laviniaangan/Audio-Preamplifier/Proiect_1_Angan_Lavinia.pdf

Universitatea Politehnica București Facultatea de Electronică, Telecomunicații și Tehnologia Informației

## PROIECT 1

## PREAMPLIFICATOR AUDIO DE INTRARE CAPITOLUL 5

Profesor coordonator: | Student: Angan Lavinia-Marilena
Dr. Ing. BABARADA Florin | Grupa: 433A

2023-2024

PREAMPLIFICATOR AUDIO DE INTRARE

Un amplificator audio de intrare este un circuit compus din o reţea de adaptare la intrare cu principalele surse de semnale audio (microfon, pick-up cu doză magnetică, pick-up cu doză ceramică, radio, magnetofon sau alte ieşiri de semnal ale aparatelor audio electronice) şi două etaje de amplificare în clasa A, respectiv etajul de intrare şi etajul de ieşire care realizează amplificarea în tensiune a semnalului. Circuitul următor are ca sursă de semnal audio un pick-up cu doză magnetică.

Amplificarea globală a amplificatorului audio de intrare este stabilită de reacţie negativă serie la intrare-paralel la ieşire iar alimentarea celor două etaje de amplificare este realizată de sursa de alimentare.
Schema bloc este prezentată în figura de mai jos:

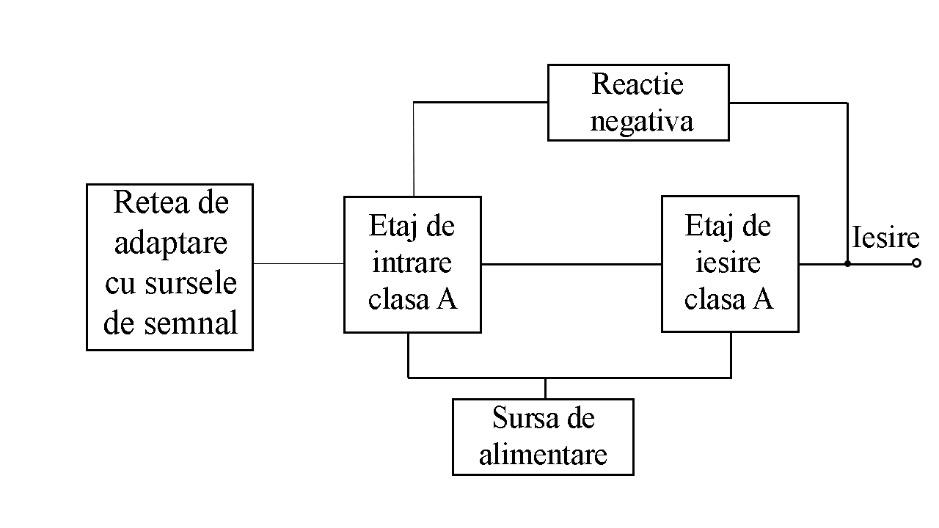
[picture p1: figure]

Figura 1. Schema bloc a amplificatorului audio de intrare

Principalii parametri ai amplificatorului audio de intrare sunt:
- Sensibilitatea minimă la intrare Vin (mV)
- Rezistenţa de intrare Ri (KΩ)
- Rezistenţa de ieşire maximă R0M (KΩ)
- Tensiunea nominală la ieşirea amplificatorului audio de putere Vn (Vef)
- Sursa de alimentare va asigura următorii parametri:
- Curentul nominal Io (mA)
- Rezistenţa de ieşire maximă R0M (Ω)
- Coeficientul de stabilizare
V Rs ct

V
S

I
Δ | =

Δ
=

0

0

≥ S0min

- Tensiunea de alimentare este 220Vac ± 10%
Nr. | Preamplificator | Sursa de alimentare
Vin (mV) | Ri (KΩ) | R0M (KΩ) | Vn (Vef) | Io (mA) | R0M (Ω) | S0min (-)
9 | 2,5 | 47 | 5 | 1,3 | 14 | 7 | 60
Setul de date de mai sus are ca sursă de semnal un microfon.

RELAȚII DE DIMENSIONARE A SCHEMEI

Alegerea tranzistorilor T1 și T2:

Semnalul de intrare este un semnal mic, deci va trebui să folosim un transistor cu zgomot redus. Am ales un echivalent al BC109C în tehnologie SMD, și anume BC846B.

T1

Se alege IC1 = 80μA, la care pentru rezistența generatorului Rg = 2/20k => F ≤ 2dB.
Se alege VCE ≥≈ 2V.
Din catalog, pentru acest PSF rezultă h11e1 ≈ 150k, h21e1 ≈ 300, h22e1 ≈ 18μA/V, h21E1 ≈ 100.

T2

Alegem IC2 = 1mA și VCE ≈ 5V. Din catalog pentru acest PSF rezultă h11e2 ≈ 15k, h21e2 ≈ 400, h22e2 ≈ 55μA/V, h21E2 ≈ 300.

Amplificarea în tensiune:

Etajul de intrare este un emitor comun, iar amplificarea este de forma:

Considerând

, rezultă că se neglijează

Pentru obținerea unor distorsiuni tranzitorii mici se impune o amplificare redusa Av,T1 ≈ -10. Din acest considerent se alege R3 = 1kΩ.

Din condițiile

și

se aleg R2 = 200k și EC = 18V. Se poate calcula exact VCE1: cu

VCE1 este mai mare decât amplitudinea semnalului de la ieșirea etajului de intrare.

Considerăm VR2 = 16.6V, VBE2 = 0.6V, deci VR5 = EC – VR2 – VBE2 = 0.8V Alegem R5 = 1kΩ, de aici rezultă IC2 = 0.8mA.

Alegem R4 = 15kΩ.

Amplificarea în tensiune a etajului de ieșire este:
(

)

Amplificarea în tensiune a etajului de intrare este:
(

)

Amplificarea în tensiune a preamplificatorului în bulcă deschisă este:

Impedanța de intrare:

Impedanța de intrare în buclă deschisă a preamplificatorului este:

R6 se dimensionează având în vedere necesitatea polarizării bazei tranzistorului: T1:

cu

deci,

Alegem R6 = 360kΩ (am ales R6 = 180 kΩ, în serie cu un rezistor de valoare 180 kΩ).

Dimensionarea condensatorilor:

Din motive de stabilitate, alegem condensatorul C4 de valoare 10uF. Având în vedere că
R1

se alege astfel încât impedanţa văzută spre amplificator să fie ≈ 47k ,
necesară pentru adaptarea cu doza magnetică şi alegând
f 1,5Hz 1 =

Þ

, F
,
C | µ
π

2 2
2 15 47 10

1

1 | 3

=
- | · | ·
= | .

Pentru dimensionarea C2 se apreciază că impedanţa la bornele sale nu va fi mai mică de 50KΩ având în vedere efectul potențiometrului de balans şi al reţelei de reacţie. Se alege
f

2 = 0,2Hz Þ

, F
f R

C

C

µ
π

15 9
2

1

2 | 2
2 | =
- ·

=

, se alege

C2 =15µF .

Se poate accepta ca valoare minima a lui P1 = 25 KΩ(P=22k si doua rezistoare cu valorile 2k,respectiv 1k) , valoarea maximă de aproximativ 100 KΩ e impusă de intrarea în circuitul corector de ton. Impedanța de ieșire a preamplificatorului fără reacție negativă este:

Cu reacție negativă, având în vedere necesitatea de amplificare pentru o valoare medie

=> impedanța de la ieșire: Zieș = = 2,2 kΩ

Valoarea lui
C3

s-a ales de
C3 = 10µF

pentru P1 = 25 kΩ.

Reacția negativă și rețelele de adaptare:

Pentru estimarea nivelului nominal al semnalului la ieşirea preamplificatorului cunoaştem:
- Amplitudinea nominală a semnalului la intrarea în amplificatorul final
- Vnom. aap = 1,3Vef
- Amplificarea circuitelor intermediare de aproximativ 5
- Atenuarea introdusă de P1 = 0,9

Pentru intrarea de microfon şi pick-up magnetic se proiectează o reţea de reacţie egalizatoare, care să corecteze caracteristica de frecvenţă a dozei magnetice. S-a adoptat corecţia după norma R.I.A.A, în care se impun următoarele constante de timp: t1=318µs, t2=75µs, t3=3180µs.
Considerând o reacţie suficient de puternică astfel încât să se poată scrie:
Avr = 1 / βr și având βr ≈ R3 / Z(ω), unde Z(ω) este impedanța grupului format din R9 , R10, C5, C6 => Avr ≈ Z / R3 = K • Z(ω)

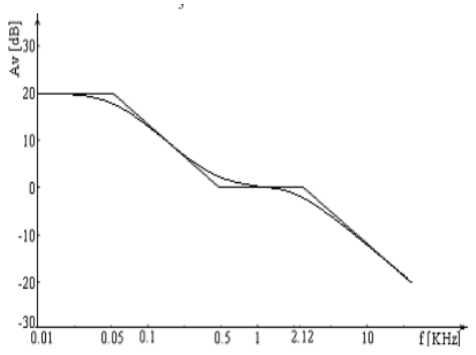
[picture p2: figure]

Figura 2. Curba de egalizare pentru doza magnetică

Z(ω) este de forma: Z(ω) = B , unde B = R9 + R10; t2 = C5R9;

t1 = (C5 + C6)

; t3 = C6R10 și R10 ≈ 11,8R9; C6 = 3,4C5.

Practic la 1kHz se poate considera Z(ω) ≈ R9 și atunci Avr, 1KHz ≈ R9 / R3.
Amplificarea necesară este Avr, 1KHz = 280mV / 2,5mV = 48 | => R9 ≈ R3Avr, 1KHz = 112kΩ.
Se adoptă R9 = 115 kΩ( doua rezistoare in serie de 100k si 15k) => R10 = 11,8R9 = 1321.6 kΩ. Se adoptă R10 = 1MΩ ( în serie cu o rezistență adițională echivalentă de 320 kΩ (formată din doi rezistori cu valoarea de 100kΩ si 220kΩ).

C5 = t2 / R9 = 0,7nF; Se alege C5 = 1nF (adaug un condensator cu valoarea de 470pF în paralel cu acesta).
C6 = t3 / R10 = 2,4nF; Se alege C6 = 2,2nF (adaug un condensator cu valoare de 470pF în paralel cu acesta).

Pentru a asigura impedanța de intrare impusa de ≈ 47 kΩ se introduce la intrarea preamplificatorului rezistența R1 care șuntează intrarea. Deoarece avem la intrare o reacție de tip serie, impedanța de intrare fară reacție și anume ZintT1 = 200 kΩ va crește βrAv .

Pentru frecvența de 1kHz, βrAv = 371 / 47 = 7.89 => impedanța de intrare în preamplificator, cu reacție este: ZInt, T1, r = βrAv • ZInT1 = 1,578 MΩ

Impedanța de intrare globală în preamplificatorul de intrare este:
Zint, pa = R1 || ZInt, T1, r = 47 kΩ || 1,578MΩ = 45,66 kΩ ≈ 46 kΩ

Simularea funcționării preamplificatorului audio de intrare:

Simularea preamplificatorului audio de intrare s-a făcut din punct de vedere al PSF-ului, al analizei tranzitorii şi al răspunsului în frecvenţă. Simularea PSF-ului ne dă o bună concordanţă cu datele de proiectare respectiv curenţii de colector şi tensiunile colector-emitor conform cu următoarea figură.

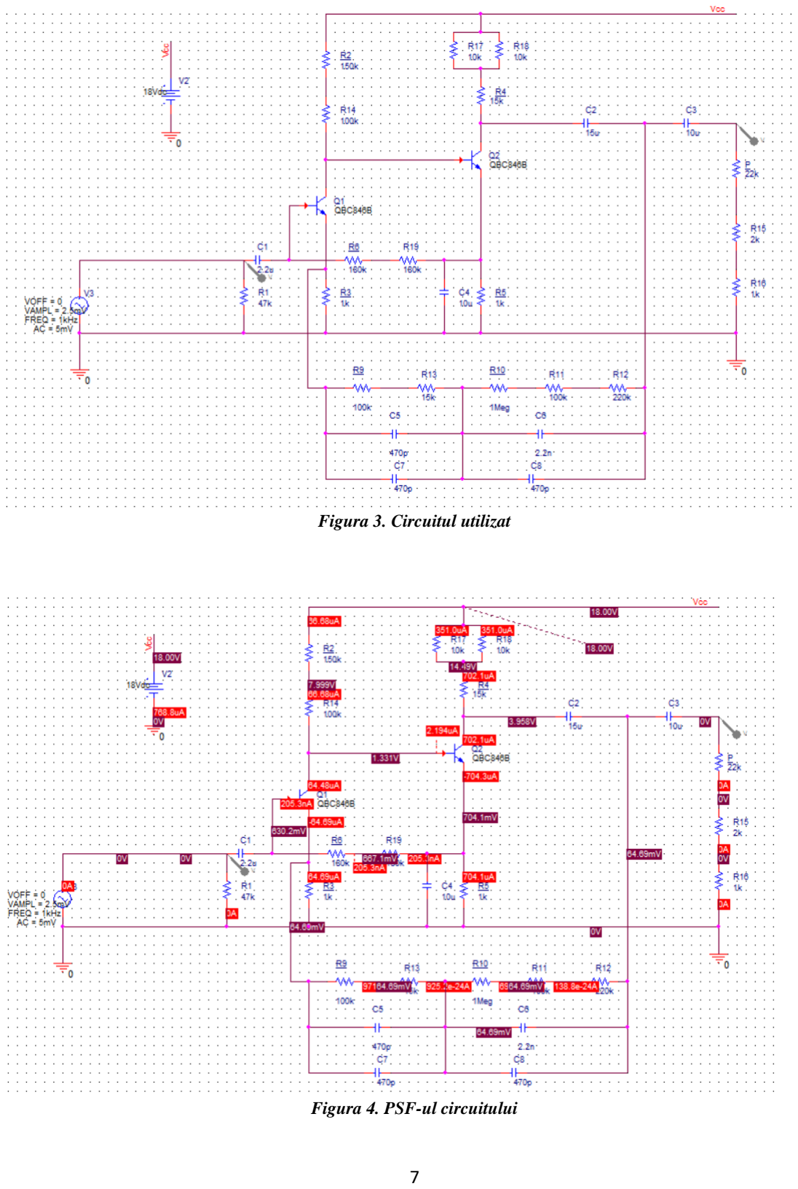
[picture p3: page 7]

Figura 3. Circuitul utilizat

Figura 4. PSF-ul circuitului

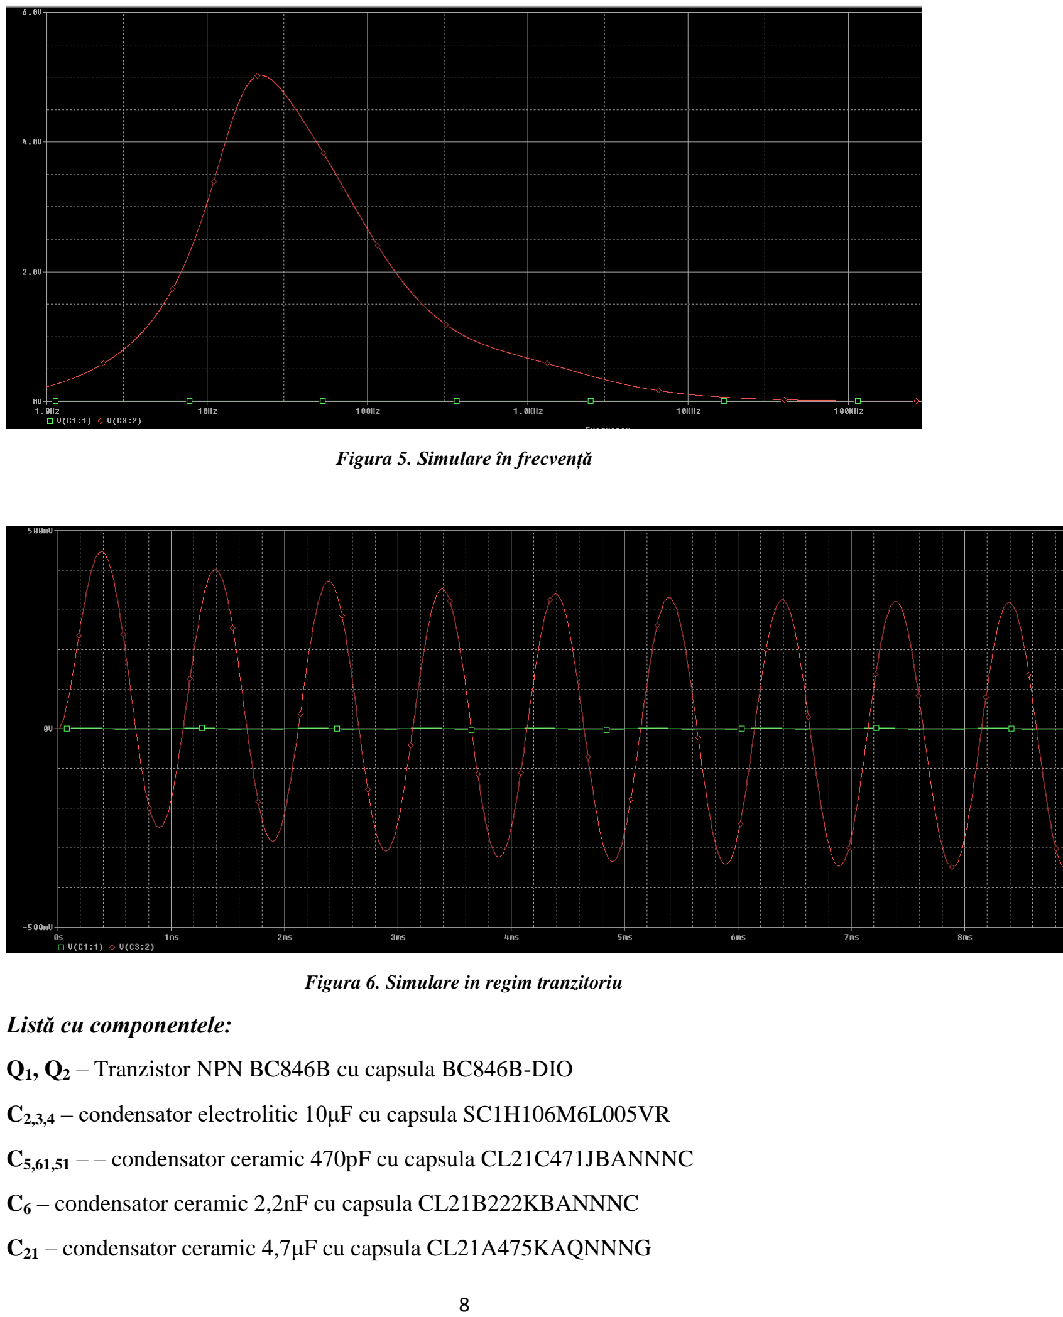
[picture p4: page 8]

Figura 5. Simulare în frecvență

Figura 6. Simulare in regim tranzitoriu

Listă cu componentele:

Q1, Q2 – Tranzistor NPN BC846B cu capsula BC846B-DIO

C2,3,4 – condensator electrolitic 10μF cu capsula SC1H106M6L005VR

C5,61,51 – – condensator ceramic 470pF cu capsula CL21C471JBANNNC

C6 – condensator ceramic 2,2nF cu capsula CL21B222KBANNNC

C21 – condensator ceramic 4,7μF cu capsula CL21A475KAQNNNG

C1 – condensator ceramic 2,2 μF cu capsula GRM21BR61H225KA73L

R1 – rezistor 47kΩ cu capsula SMD0805-47K

R2 – rezistor 150kΩ cu capsula SMD0805-150K

R21, R9 – rezistor 100kΩ cu capsula SMD0805-100K

R3,5 , P2 – rezistor 1kΩ cu capsula SMD0805-1K

R4,41,42 – rezistor 10kΩ cu capsula SMD0805-10K

R6,61 – rezistor 180kΩ cu capsula SMD0805-180K

R91 – rezistor 15kΩ cu capsula SMD0805-15K

R10 , R11 – rezistor 510kΩ cu capsula SMD0805-510K

R12 – rezistor 220kΩ cu capsula SMD0805-220K

P92 – rezistor 22kΩ cu capsula SMD0805-22K

P1– rezistor 2kΩ cu capsula SMD0805-2K

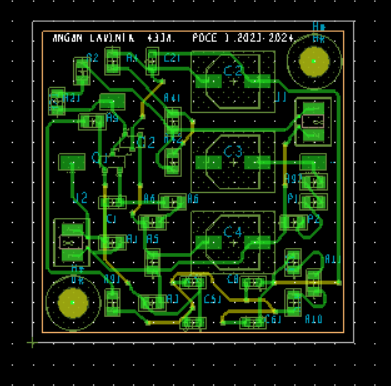
[picture p5: figure]

Figura 8. Layout-ul circuitului

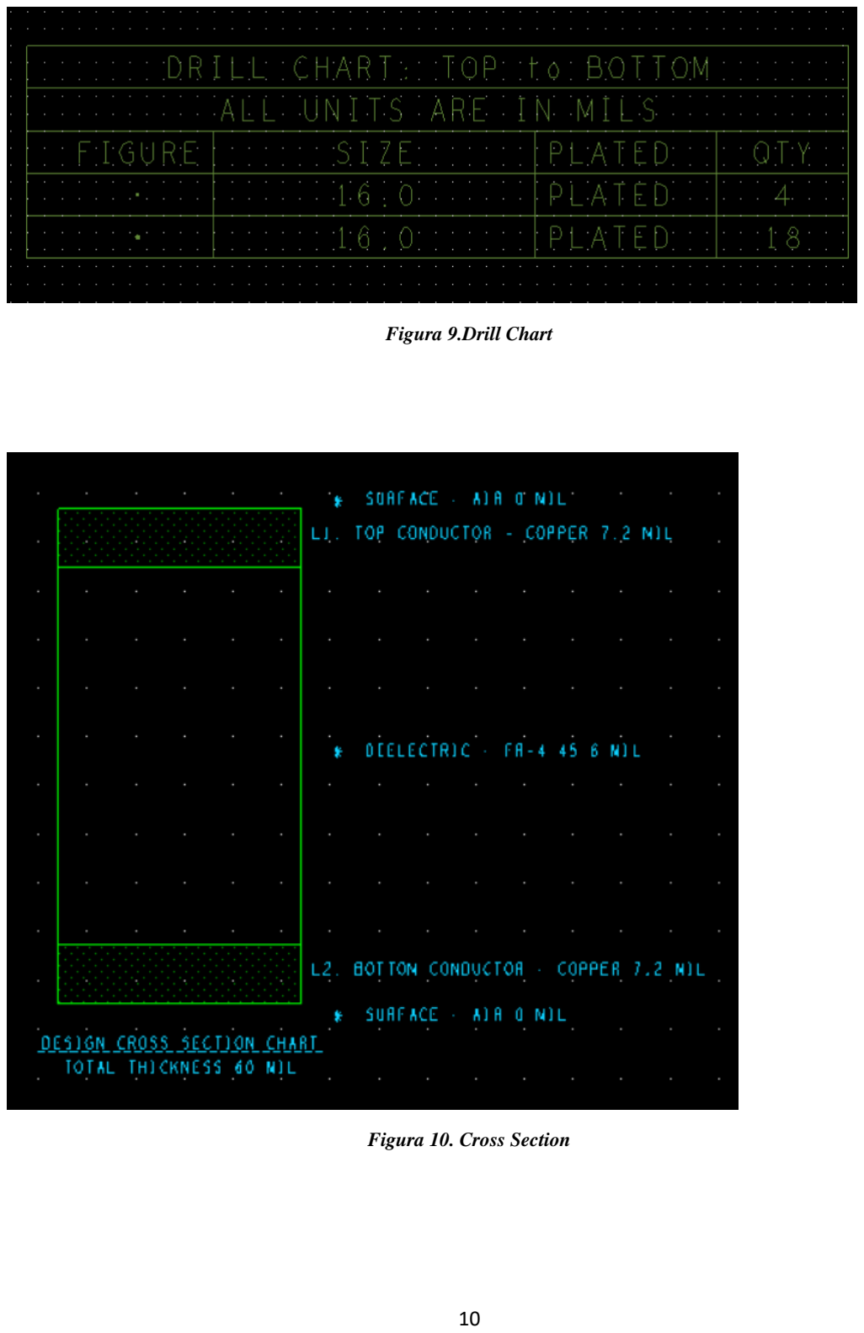
[picture p6: page 10]

Figura 9.Drill Chart

Figura 10. Cross Section

BIBLIOGRAFIE:

„Proiectarea Circtuitelor Electronice de Audiofrecvență” de Florin Babarada – Editura Printech, 2003
