laviniaangan/Audio-Preamplifier/Simulations/Simulare Frecventa.jpg

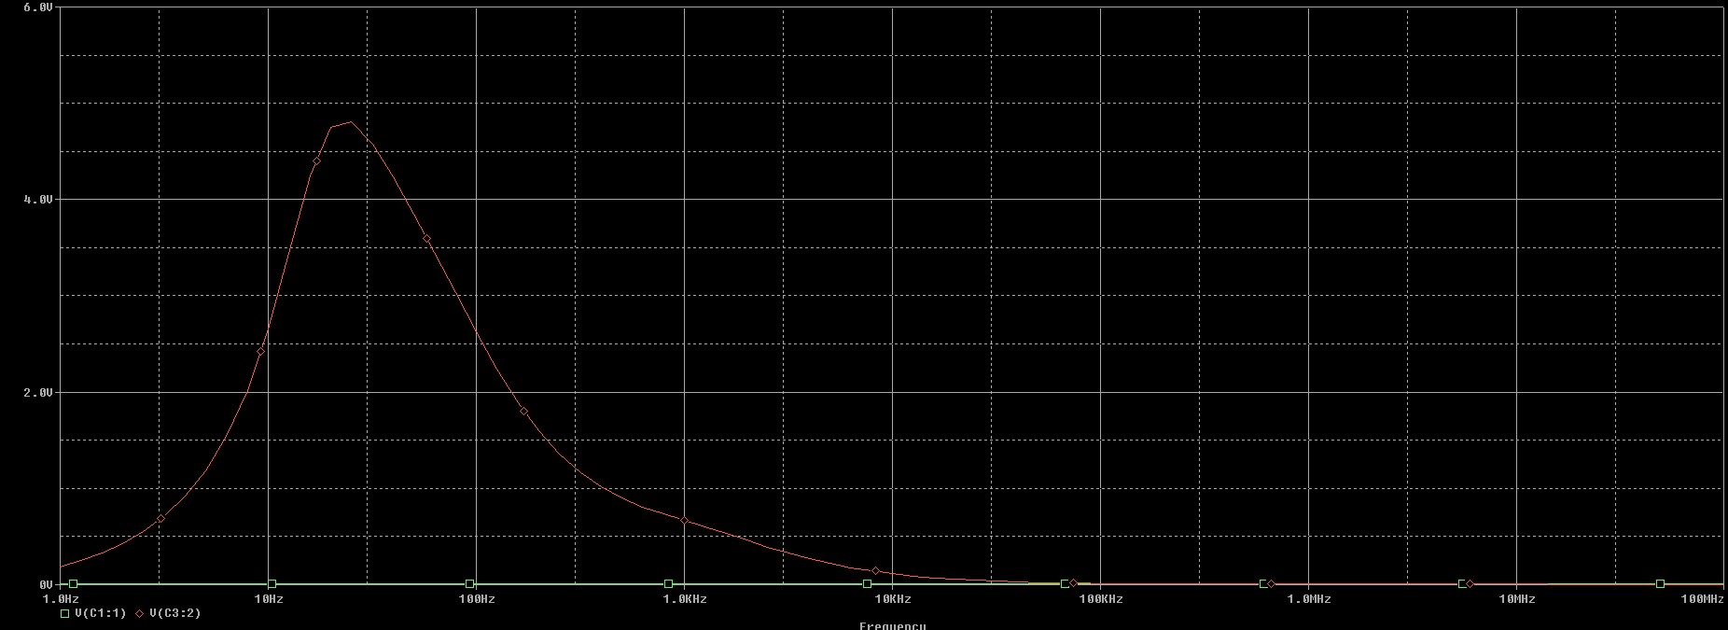
Simulations/Simulare Frecventa.jpg
