laviniaangan/Audio-Preamplifier/Simulations/Simulare Regim Tranzitoriu.jpg

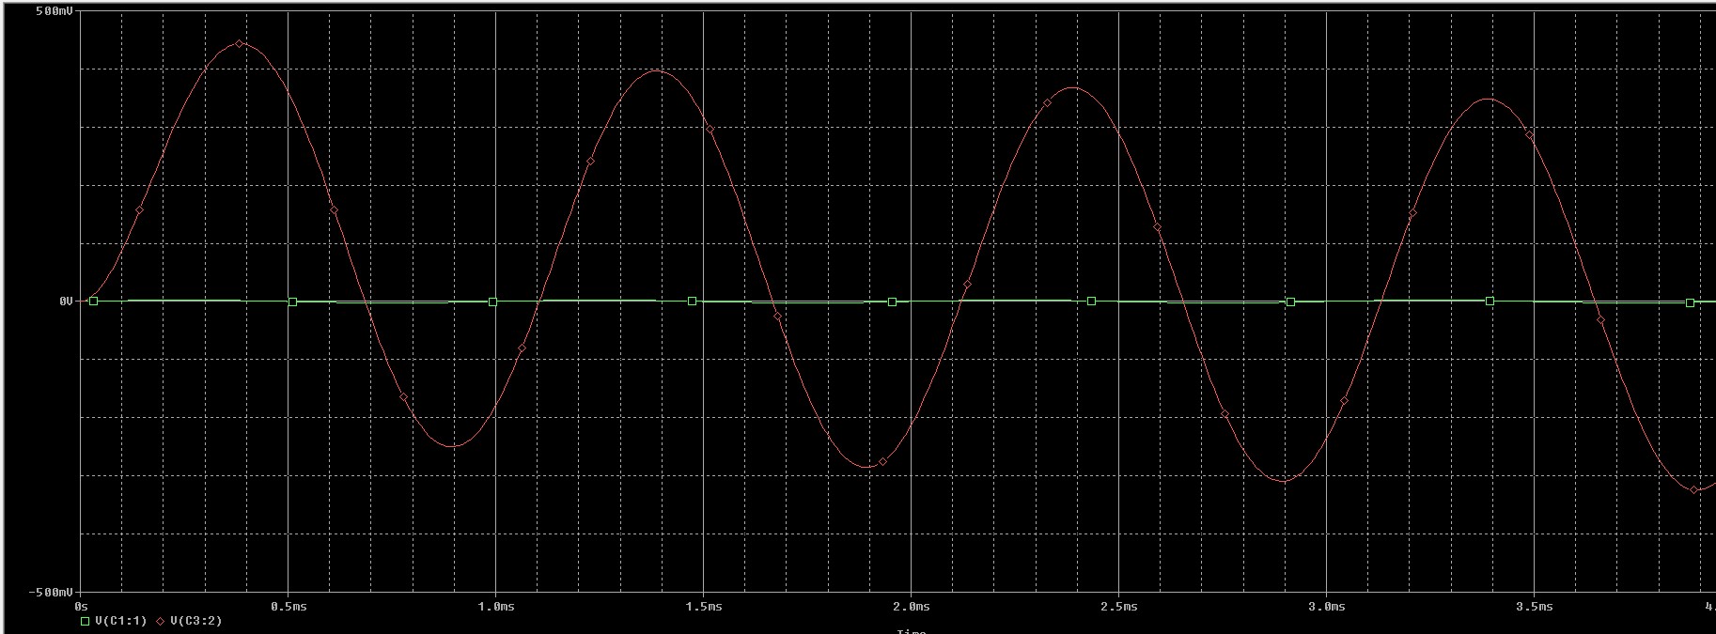
Simulations/Simulare Regim Tranzitoriu.jpg
