laviniaangan/Audio-Preamplifier/(list of files, drawings)

Other design files:
Schematics/Proiect_1.dsn
Schematics/Proiect_1.opj
